jrsikken/SEM/SEMLIC V2.jpg

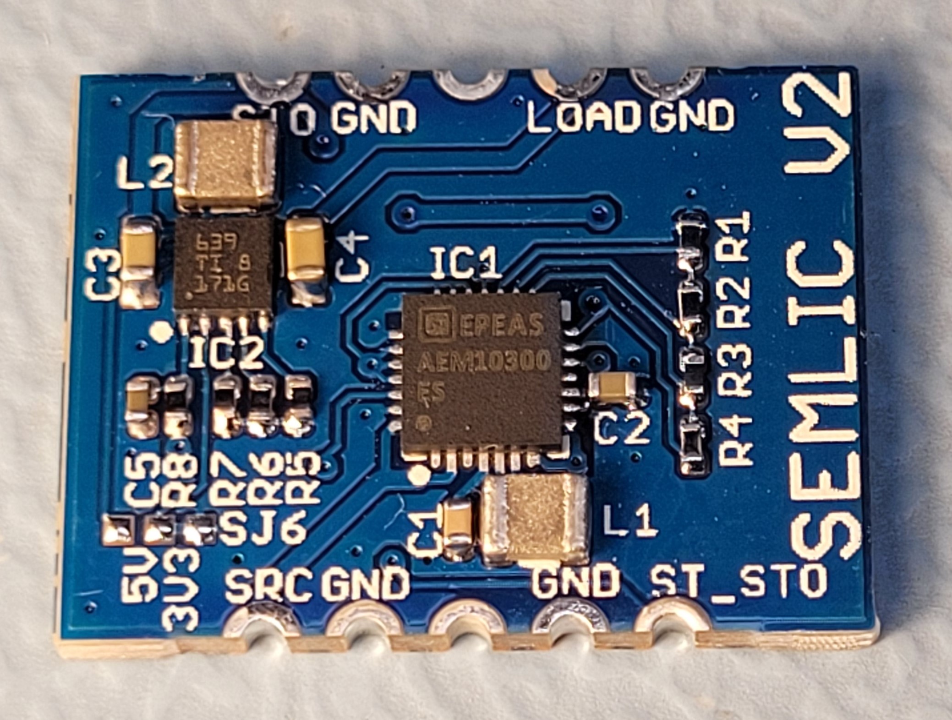
SEMLIC V2.jpg
