jrsikken/SEM/SEM V1.png

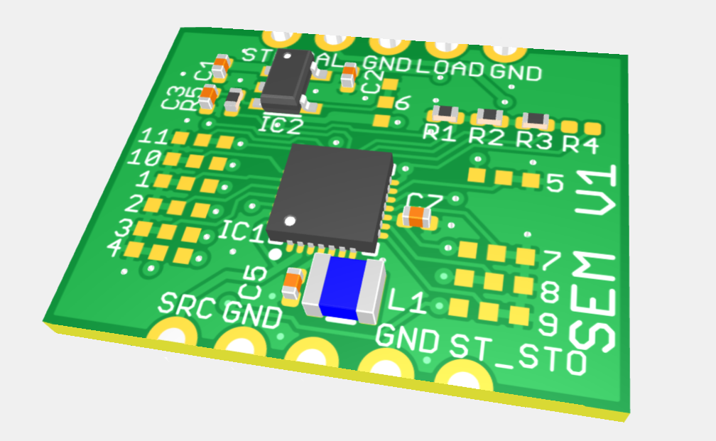
SEM V1.png
