jrsikken/SEM/README.md

# SEM
A tiny board with AEM10330 solar harvesting IC and regulated output
