jrsikken/SEM/SEMLIC v1 schematic.png

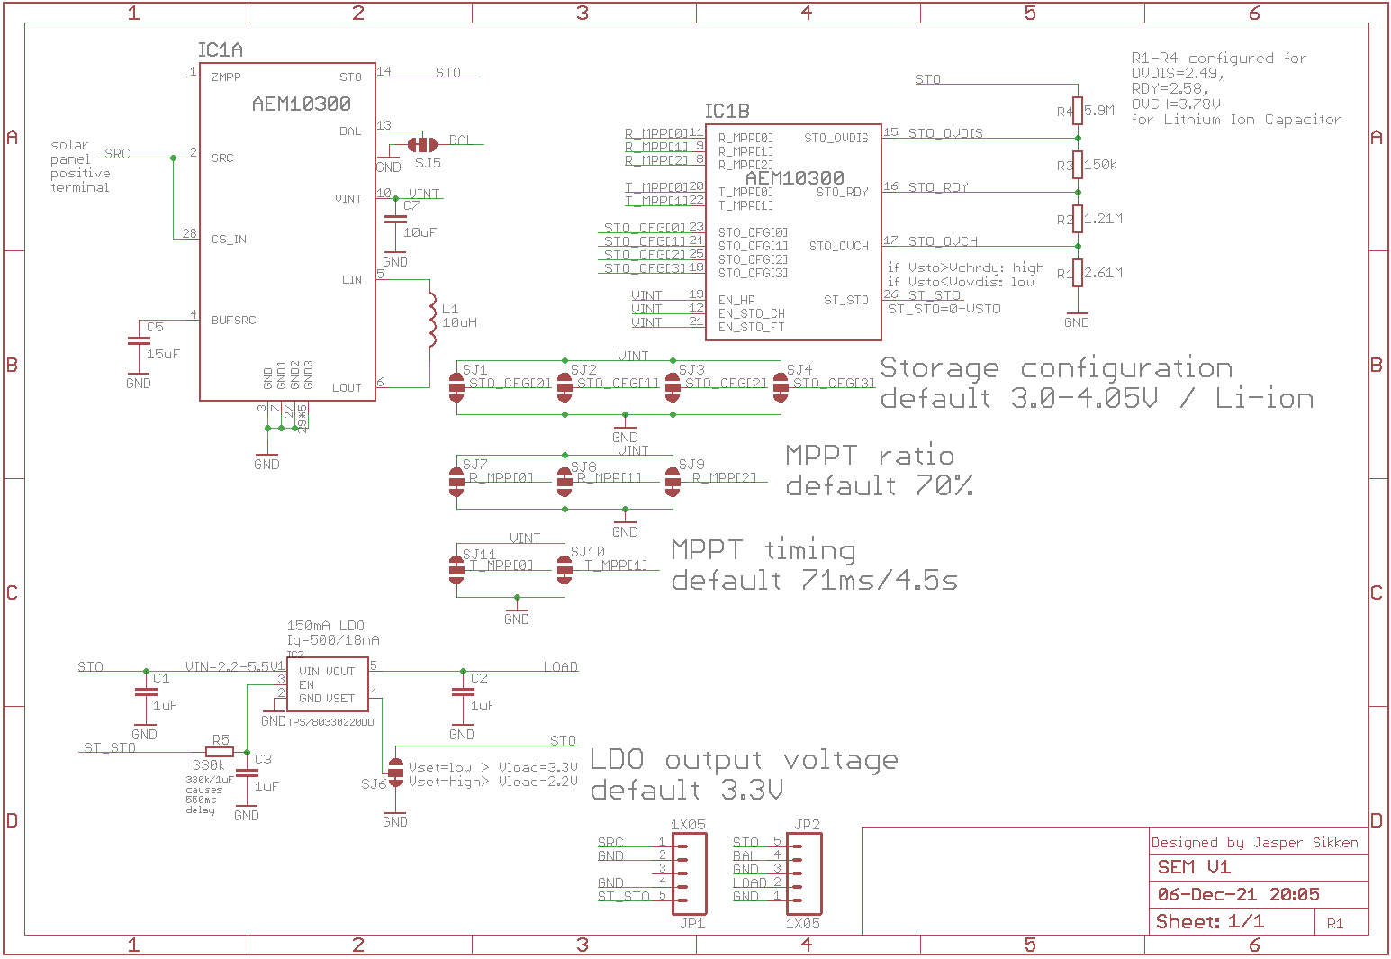
SEMLIC v1 schematic.png
