jrsikken/SEM/SEMLIC V2 schematic.png

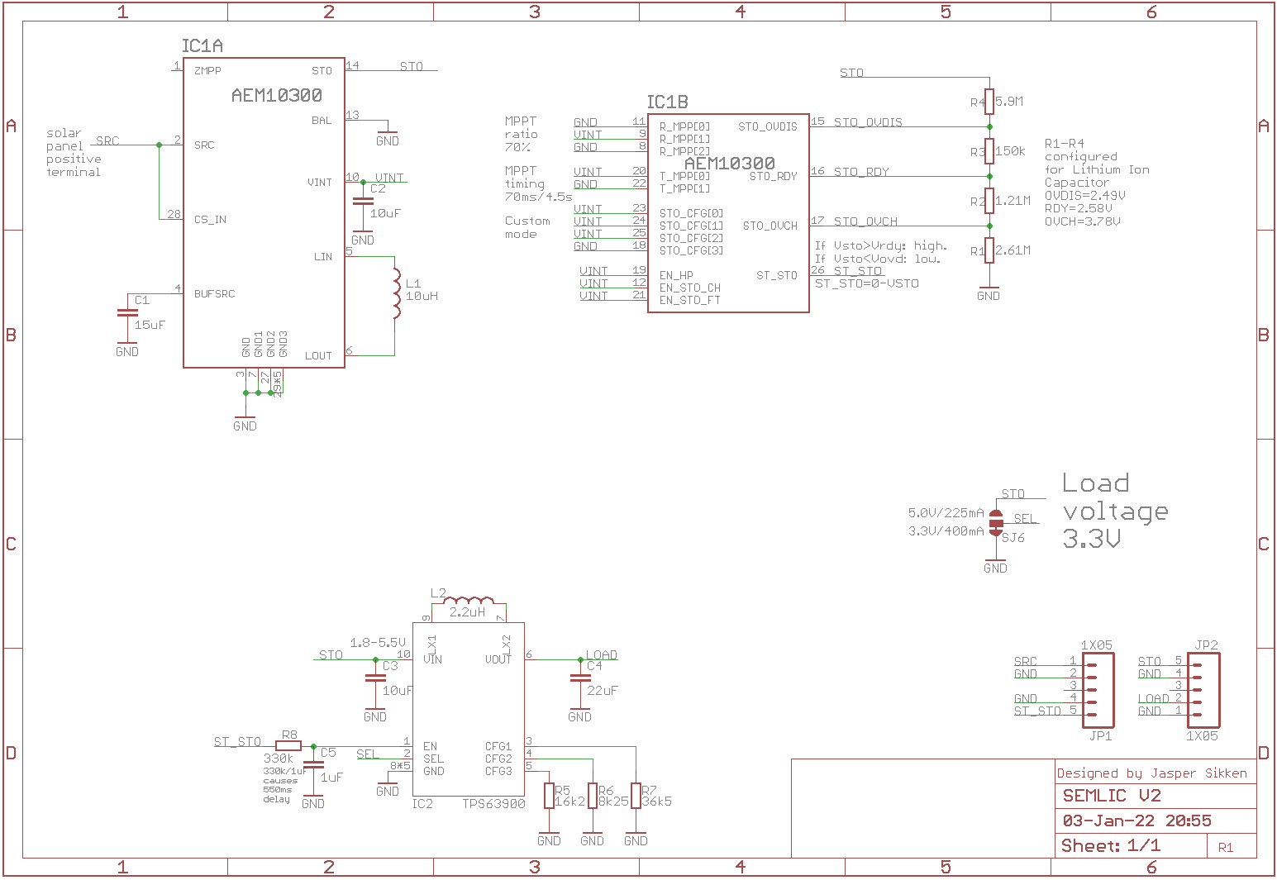
SEMLIC V2 schematic.png
