jrsikken/SEM/SEMLIC V2 BOM.xlsx

Qty | Value | Parts | Description | MF | MPN | have
1 | 15uF | C1 | Cap 6.3v X5R 15uF 20% 0402 | MURATA | GRM155R60J156ME05 | 8
1 | 10uF | C2 | Cap 10 μF, 6.3V, 20%, X5R 0402 | MURATA | CC0402MRX5R5BB106 | 8
1 | 10uF | C3 | Cap 10 μF, 10V, 20%, X5R, 0603 |  |  | 220
1 | 22uF | C4 | Cap 22uF, 10V, 20%, X5R, 0603 |  |  | 220
1 | 1uF | C5 | Cap 1uF, 10V, X5R, 20%, 0402 |  |  | 18
1 | AEM10300 | IC1 | Energy harvesting PMIC | E-peas | AEM10300 | 4
1 | TPS63900 | IC2 | Buck boost PMIC | Texas Instruments | TPS63900 | 220
1 | 10uH | L1 | Inductor 10uH 20% 1MHz 0.9A 0.6Ohm | MURATA | DFE252010F-100M | 9
1 | 2.61M | R1 | Res 2.61M 0402 1% |  |  | 50
1 | 1.21M | R2 | Res 1.21M 0402 1% |  |  | 30
1 | 150k | R3 | Res 150k 0402 1% |  |  | 220
1 | 5.9M | R4 | Res 5.9M 0402 1% |  |  | 40
1 | 16k2 | R5 | 16k2 0402 1% 200ppm |  |  | 220
1 | 8k25 | R6 | 8k25 0402 1% 200ppm |  |  | 220
1 | 36k5 | R7 | 36k5 0402 1% 200ppm |  |  | 220
1 | 330k | R8 | Res 330k 0402 1% |  |  | 220
1 | 2.2uH | L2 | Inductor 2.2uH 20% 1MHz 2.3A 0.082Ohm |  | DFE252012F-2R2M=P2 | 220
