jrsikken/SEM/SEM V1 BOM.xlsx

Qty | need | have | Value | Package | Parts | Description | MF | MPN
2 | 10 | 20 | 1.21M | R0402 | R2, R5 | Res Thick Film 0402 1.21M Ohm 1% | Vishay | CRCW04021M21FKED
1 | 5 |  | 10uF | C0402 | C7 | Cap 10 μF, 6.3V, 20%, X5R | MURATA | CC0402MRX5R5BB106
1 | 5 |  | 10uH | L1008 | L1 | Inductor Power Chip Shielded Wirewound 10uH 20% 1MHz Metal 0.9A 0.6Ohm | MURATA | DFE252010F-100M
1 | 5 |  | 150k | R0402 | R3 | Resistor |  | RK73H1ETTP1503F
1 | 5 |  | 15uF | C0402 | C5 | Cap 6.3v X5R 15uF 20% | MURATA | GRM155R60J156ME05
2 | 10 |  | 1uF | C0402 | C1, C2 | Cap 16V X5R 20% |  | C0402C105M4PACTU
1 | 5 | 20 | 2.61M | R0402 | R1 | Res Thick Film 0402 2.61M Ohm 1% |  | CRCW04022M61FKED
1 | 5 | 30 | 5.9M | R0402 | R4 | Res Thick Film 0402 5.9M Ohm 1% |  | CRCW04025M90FKED
1 | 5 | 5 | AEM10300 | QFN28P4X4 | IC1 | Ambient Energy Manager from e-peas | E-peas | AEM10300
1 | 5 | 10 | TPS780330220DD | SOT23-5 | IC2 |  | Texas Instruments | TPS780330220DDCT
 |  |  | 220nF |  | C3
