jrsikken/SEM/SEMLIC V2.brd

## EAGLE design SEMLIC V2.brd (2022-01-05)

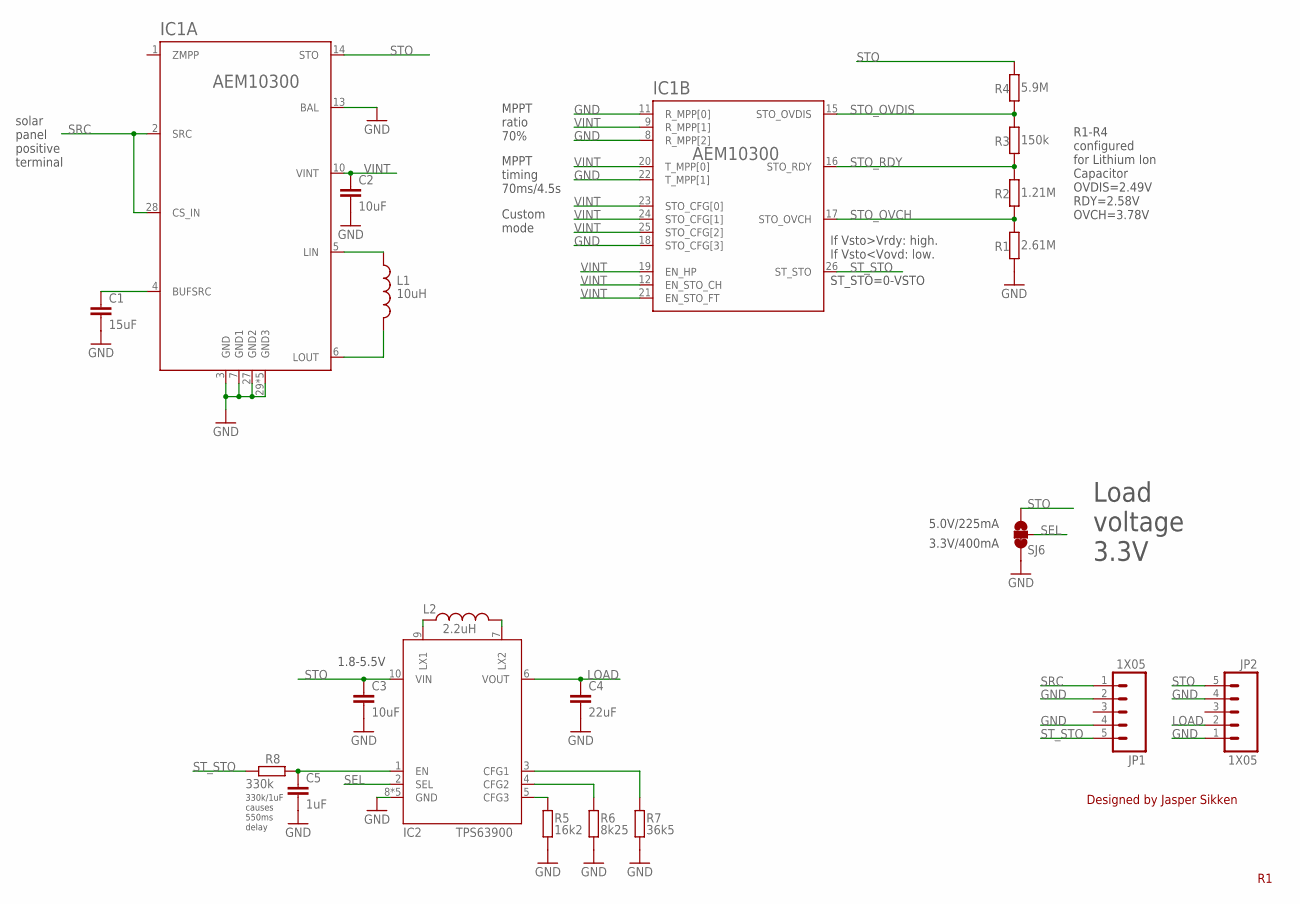
[picture p5: schematic SEMLIC V2.sch]

Parts:
C1: 15uF; C0402
C2: 10uF; C0402
C3: 10uF; C0603
C4: 22uF; C0603
C5: 1uF; C0402
IC1: AEM10300; QFN28P4X4
IC2: TPS63900; WSON10
JP1, JP2: 1X05; 1X05_2.54MM_ROUND_NOSILK
L1: 10uH; L_1008_[2520]
L2: 2.2uH; L_1008_[2520]
R1: 2.61M; R0402
R2: 1.21M; R0402
R3: 150k; R0402
R4: 5.9M; R0402
R5: 16k2; R0402
R6: 8k25; R0402
R7: 36k5; R0402
R8: 330k; R0402
SJ6: SOLDERJUMPER_3WAY_12SHORT3WAY; SJ_3S_NC_0402

Connections:
BUFSRC: C1.1, IC1.4 (BUFSRC)
GND: C1.2, C2.2, C3.2, C4.2, C5.2, IC1.3 (GND), IC1.7 (GND1), IC1.8 (R_MPP[2]), IC1.11 (R_MPP[0]), IC1.13 (BAL), IC1.18 (STO_CFG[3]), IC1.22 (T_MPP[1]), IC1.27 (GND2), IC1.29 (GND3), IC1.P$1 (GND3), IC1.P$2 (GND3), IC1.P$3 (GND3), IC1.P$4 (GND3), IC2.8 (GND), IC2.29 (GND), IC2.P$2 (GND), IC2.P$4 (GND), IC2.P$5 (GND), JP1.2, JP1.4, JP2.1, JP2.4, R1.1, R5.2, R6.2, R7.2, SJ6.1
LIN: IC1.5 (LIN), L1.1
LOAD: C4.1, IC2.6 (VOUT), JP2.2
LOUT: IC1.6 (LOUT), L1.2
unnamed: IC2.9 (LX1), L2.1
unnamed: IC2.7 (LX2), L2.2
unnamed: IC2.5 (CFG3), R5.1
unnamed: IC2.4 (CFG2), R6.1
unnamed: IC2.3 (CFG1), R7.1
SEL: IC2.2 (SEL), SJ6.2
SRC: IC1.2 (SRC), IC1.28 (CS_IN), JP1.1
STO: C3.1, IC1.14 (STO), IC2.10 (VIN), JP2.5, R4.2, SJ6.3
STO_OVCH: IC1.17 (STO_OVCH), R1.2, R2.1
STO_OVDIS: IC1.15 (STO_OVDIS), R3.2, R4.1
STO_RDY: IC1.16 (STO_RDY), R2.2, R3.1
ST_STO: IC1.26 (ST_STO), JP1.5, R8.2
TPS_EN: C5.1, IC2.1 (EN), R8.1
VINT: C2.1, IC1.9 (R_MPP[1]), IC1.10 (VINT), IC1.12 (EN_STO_CH), IC1.19 (EN_HP), IC1.20 (T_MPP[0]), IC1.21 (EN_STO_FT), IC1.23 (STO_CFG[0]), IC1.24 (STO_CFG[1]), IC1.25 (STO_CFG[2])

Notes on the sheet:
Designed by Jasper Sikken
solar panel positive terminal
3.3V/400mA
ST_STO=0-VSTO
If Vsto>Vrdy: high. If Vsto<Vovd: low.
Load voltage 3.3V
R1-R4 configured for Lithium Ion Capacitor OVDIS=2.49V RDY=2.58V OVCH=3.78V
330k/1uF causes 550ms delay
1.8-5.5V
5.0V/225mA
Custom mode
MPPT ratio 70%
MPPT timing 70ms/4.5s

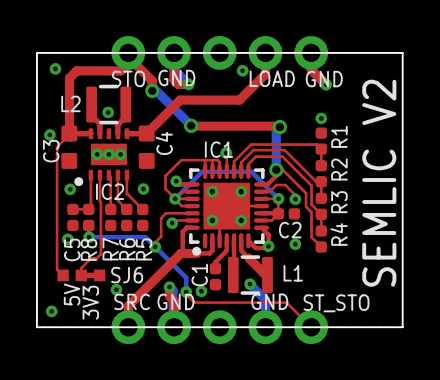
[picture p6: board SEMLIC V2.brd from above]

Board: 2 copper layers, 20.3 x 15.2 mm, 20 parts (0 on the bottom side), 19 nets.
