jrsikken/SEM/SEM V1.brd

## EAGLE design SEM V1.brd (2021-12-06)

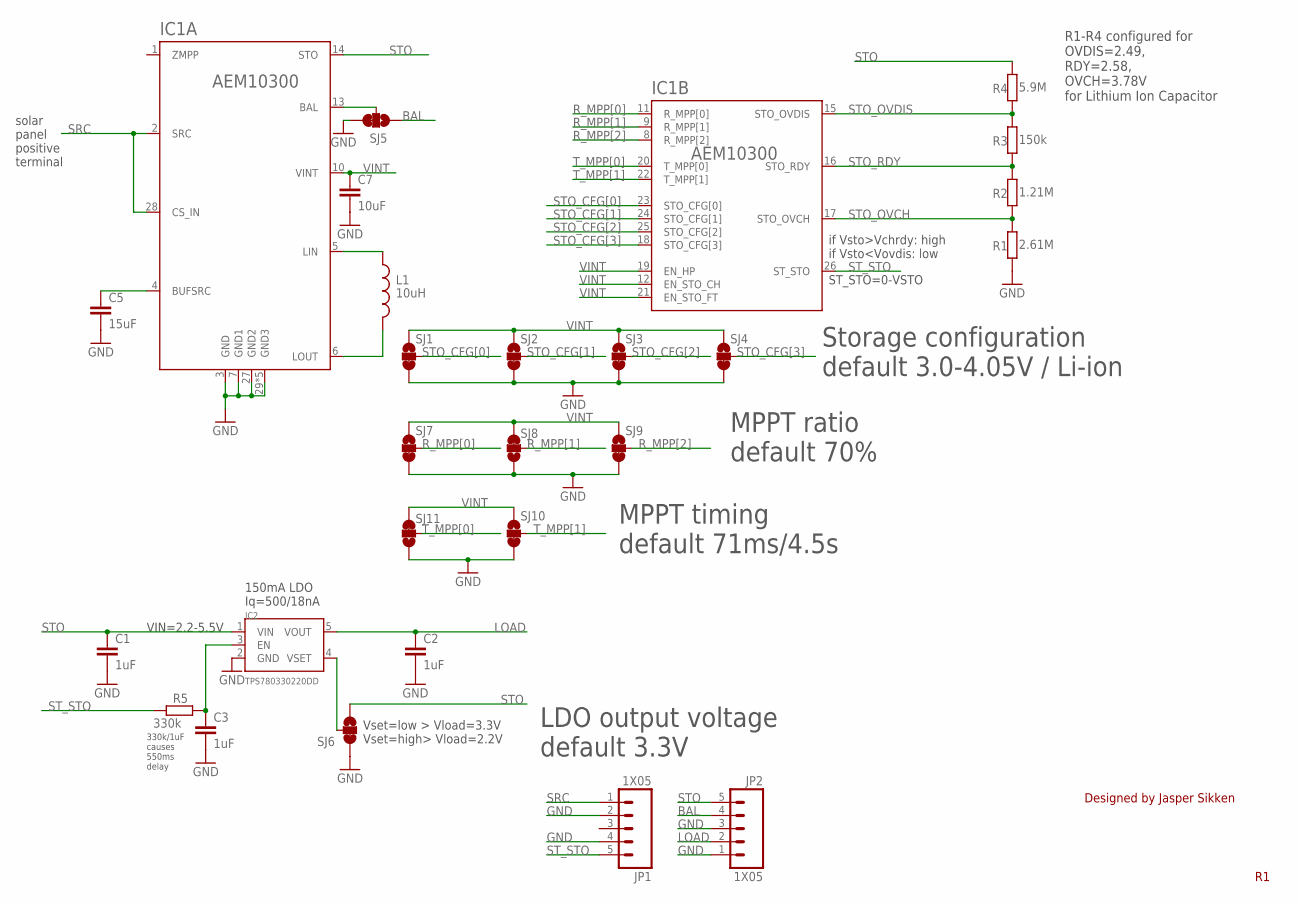
[picture p7: schematic SEM V1.sch]

Parts:
C1, C2, C3: 1uF; C0402
C5: 15uF; C0402
C7: 10uF; C0402
IC1: AEM10300; QFN28P4X4
IC2: TPS780330220DD; SOT23-5
JP1, JP2: 1X05; 1X05_2.54MM_ROUND_NOSILK
L1: 10uH; L_1008_[2520]
R1: 2.61M; R0402
R2: 1.21M; R0402
R3: 150k; R0402
R4: 5.9M; R0402
R5: 330k; R0402
SJ1, SJ2, SJ3, SJ4, SJ5, SJ6, SJ7, SJ8, SJ9, SJ10, SJ11: SOLDERJUMPER_3WAY_12SHORT3WAY; SJ_3S_NC_0402

Connections:
AEM_BAL: IC1.13 (BAL), SJ5.2
BAL: JP2.4, SJ5.3
BUFSRC: C5.1, IC1.4 (BUFSRC)
EN: C3.1, IC2.3 (EN), R5.1
GND: C1.2, C2.2, C3.2, C5.2, C7.2, IC1.3 (GND), IC1.7 (GND1), IC1.27 (GND2), IC1.29 (GND3), IC1.P$1 (GND3), IC1.P$2 (GND3), IC1.P$3 (GND3), IC1.P$4 (GND3), IC2.2 (GND), JP1.2, JP1.4, JP2.1, JP2.3, R1.1, SJ1.1, SJ2.1, SJ3.1, SJ4.1, SJ5.1, SJ6.1, SJ7.1, SJ8.3, SJ9.1, SJ10.1, SJ11.3
LIN: IC1.5 (LIN), L1.1
LOAD: C2.1, IC2.5 (VOUT), JP2.2
LOUT: IC1.6 (LOUT), L1.2
R_MPP[0]: IC1.11 (R_MPP[0]), SJ7.2
R_MPP[1]: IC1.9 (R_MPP[1]), SJ8.2
R_MPP[2]: IC1.8 (R_MPP[2]), SJ9.2
SRC: IC1.2 (SRC), IC1.28 (CS_IN), JP1.1
STO: C1.1, IC1.14 (STO), IC2.1 (VIN), JP2.5, R4.2, SJ6.3
STO_CFG[0]: IC1.23 (STO_CFG[0]), SJ1.2
STO_CFG[1]: IC1.24 (STO_CFG[1]), SJ2.2
STO_CFG[2]: IC1.25 (STO_CFG[2]), SJ3.2
STO_CFG[3]: IC1.18 (STO_CFG[3]), SJ4.2
STO_OVCH: IC1.17 (STO_OVCH), R1.2, R2.1
STO_OVDIS: IC1.15 (STO_OVDIS), R3.2, R4.1
STO_RDY: IC1.16 (STO_RDY), R2.2, R3.1
ST_STO: IC1.26 (ST_STO), JP1.5, R5.2
T_MPP[0]: IC1.20 (T_MPP[0]), SJ11.2
T_MPP[1]: IC1.22 (T_MPP[1]), SJ10.2
VINT: C7.1, IC1.10 (VINT), IC1.12 (EN_STO_CH), IC1.19 (EN_HP), IC1.21 (EN_STO_FT), SJ1.3, SJ2.3, SJ3.3, SJ4.3, SJ7.3, SJ8.1, SJ9.3, SJ10.3, SJ11.1
VSET: IC2.4 (VSET), SJ6.2

Notes on the sheet:
Designed by Jasper Sikken
solar panel positive terminal
MPPT ratio default 70%
150mA LDO Iq=500/18nA
Vset=low > Vload=3.3V Vset=high> Vload=2.2V
VIN=2.2-5.5V
ST_STO=0-VSTO
if Vsto>Vchrdy: high if Vsto<Vovdis: low
Storage configuration default 3.0-4.05V / Li-ion
MPPT timing default 71ms/4.5s
LDO output voltage default 3.3V
R1-R4 configured for OVDIS=2.49, RDY=2.58, OVCH=3.78V for Lithium Ion Capacitor
330k/1uF causes 550ms delay

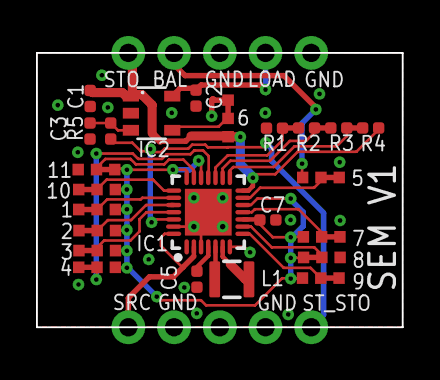
[picture p8: board SEM V1.brd from above]

Board: 2 copper layers, 20.3 x 15.2 mm, 26 parts (0 on the bottom side), 25 nets.
