jrsikken/SEM/SEMLIC V2 hardware design verification .xlsx

Function to test | how to test | expected outcome | measured outcome | result | comment
PCBA solder quality good | visual | good | good | pass
PCBA component orientation / pin1 | visual | correct | correct | pass
Bill of materials correct | measure using multimeter as far as possible | correct | correct | pass
Check component marking | see datasheet | correct | correct | pass
BUFSRC voltage | multimeter | 2.2V | 2.16V | pass
MPPT ratio | measure SRC voltage using scope | 70% | 68% | pass
MPPT timing | measure SRC voltage using scope | 70ms/4.5s | 70ms/4.34s | pass
STO OVCH voltage | measure STO using multimeter | 3.78V | 3.78V | pass
STO RDY voltage | measure at what STO voltage ST_STO goes high | 2.58V | 2.60V | pass
STO OVDIS voltage | measure at what STO voltage ST_STO goes low | 2.49V | 2.44V | pass
ST_STO level | using multimeter and scope | 0/V_STO | 0/3.76V | pass
ST_STO is high when there is light | connect solar panel | constant high | varies with light | fail | also tested with SEMLIC V1
measure TPS63900 EN signal level | using multimeter and scope | 0/V_STO
TPS disable time | using scope | 550ms
LOAD voltage 3.3V at 0mA load | using scope and multimeter (src=Vinatech 250F) ST_STO=STO | 3.3V | 3.33V | pass
LOAD voltage 3.3V at 440mA (7.5 ohm load) | using scope and multimeter (src=Vinatech 250F) ST_STO=STO | 3.3V | 3.30V | pass
LOAD voltage 5.0V at 0mA load | using scope and multimeter (src=Vinatech 250F) ST_STO=STO | 5.0V | 5.06V | pass
LOAD voltage 5V at 250mA (20 ohm load) | using scope and multimeter (src=Vinatech 250F) ST_STO=STO | 5.0V | 5.00V | pass
current test | using otii | <100mA
thermal camera test | using seek thermal camera | < 50 degrees C
