jrsikken/SEM/SEM V1 hardware design verification.xlsx

Function to test | how to test | expected outcome | measured outcome | result | comment
PCB thickness | caliper | 1.60 | 1.60 | pass
PCB dimensions / holes diameter | caliper | 32.50x22.3mm |  | pass
PCB copper track and clearance | caliper | looks good |  | pass
PCB soldermask, check fine pitch components | visual | looks good |  | pass
VINT | multimeter | 2.20 | 2.18 | pass
VOVDIS (Li-ion) | measure VSTO and ST STO | 3.00 | 3.00 | pass
VCHRDY (Li-ion) | measure VSTO and ST STO | 3.50 | 3.50 | pass
VOVCH (Li-ion) | multimeter | 4.05 | 4.01 | pass
STO HIGH | scope | VSTO | VSTO | pass
MPPT ratio one value | scope | 0.70 | 0.70 | pass
MPPT timing | scope | 71ms-4.5s | 70ms-4.5s | pass
LOAD 3.3V | multimeter | 3.30 | 3.36 | pass
LOAD 3.3V at 220mA load | 15ohm | 3.30 | 3.28 | pass
LOAD 2.2V | multimeter | 2.20 | 2.23 | pass
LOAD 2.2V at 150mA load | 15ohm | 2.20 | 2.19 | pass
Delay ST_STO and LDO out | 330k/1uF | ~0.5s | 0.55s | pass
